junw-lab/halfLife/board.png

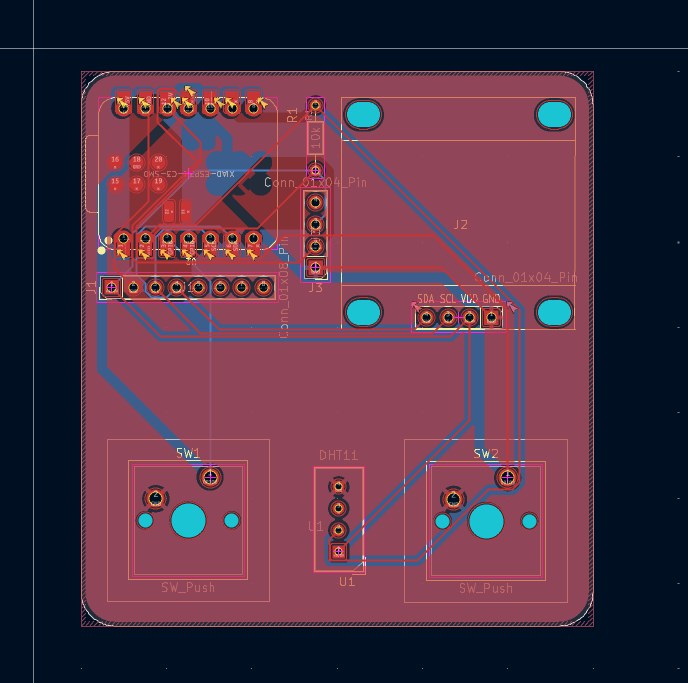
board.png
