junw-lab/halfLife/BOM.md

# Starbie – bill of materials

<!-- Generated by Half Life from project cmuvq4d1102cu01o92k2wubfl. Edits here are overwritten on the next sync. -->
<!-- Generated: 2026-10-11T10:39:23.504Z -->

> [!NOTE]
> This parts list is mirrored from [Half Life](https://halflife.hackclub.com). Editing it here will not change the platform's copy, and the next sync overwrites this file.

| Week | Tier | Parts funding |
| --- | --- | --- |
| Week 1 | Tier 1 | $30.00 |

| Part | What it's for | Qty | Unit | Total | Vendor |
| --- | --- | --- | --- | --- | --- |
| [PCB](https://jlcpcb.com/) | PCB | 1 | $1.50 | $1.50 | [JLCPCB](https://jlcpcb.com/) |
| [ESP 32 C3](https://www.aliexpress.com/item/1005008233414789.html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) | ESP | 1 | $5.62 | $5.62 | [Aliexpress](https://www.aliexpress.com/item/1005008233414789.html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) |
| [Brown Switch](https://www.aliexpress.com/item/1005006376024657.html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) | Switches | 10 | $0.32 | $3.20 | [Aliexpress](https://www.aliexpress.com/item/1005006376024657.html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) |
| [DHT 11](https://www.aliexpress.com/item/1005013226783513.html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) | temperature and humidity sensor | 1 | $2.10 | $2.10 | [Aliexpress](https://www.aliexpress.com/item/1005013226783513.html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) |
| [Keycaps](https://www.aliexpress.com/item/1005010720096151.html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) | Keycap | 10 | $0.27 | $2.70 | [Aliexpress](https://www.aliexpress.com/item/1005010720096151.html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) |
| [Oled module](https://www.aliexpress.com/item/32896971385.html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) | Screen | 1 | $1.60 | $1.60 | [Aliexpress](https://www.aliexpress.com/item/32896971385.html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) |
| [10k resistor](https://www.aliexpress.com/item/32952657927.html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) | resistors | 1 | $1.23 | $1.23 | [aliexpress](https://www.aliexpress.com/item/32952657927.html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) |
| [MPU 6050](https://www.aliexpress.com/item/1005008639359144.html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) | motion tracking | 1 | $2.33 | $2.33 | [Aliexpress](https://www.aliexpress.com/item/1005008639359144.html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) |
| **Parts subtotal** | — | — | — | **$20.28** | — |
| **Tax & shipping** | — | — | — | **$11.50** | — |
| **Total** | — | — | — | **$31.78** | — |

**$1.78 over the tier's funding.** Every tier gives a fixed amount for parts, so this needs cutting back or a higher tier.
