junw-lab/halfLife/KiCad Project.kicad_pcb

## KiCad design KiCad Project.kicad_pcb (2026-10-11)

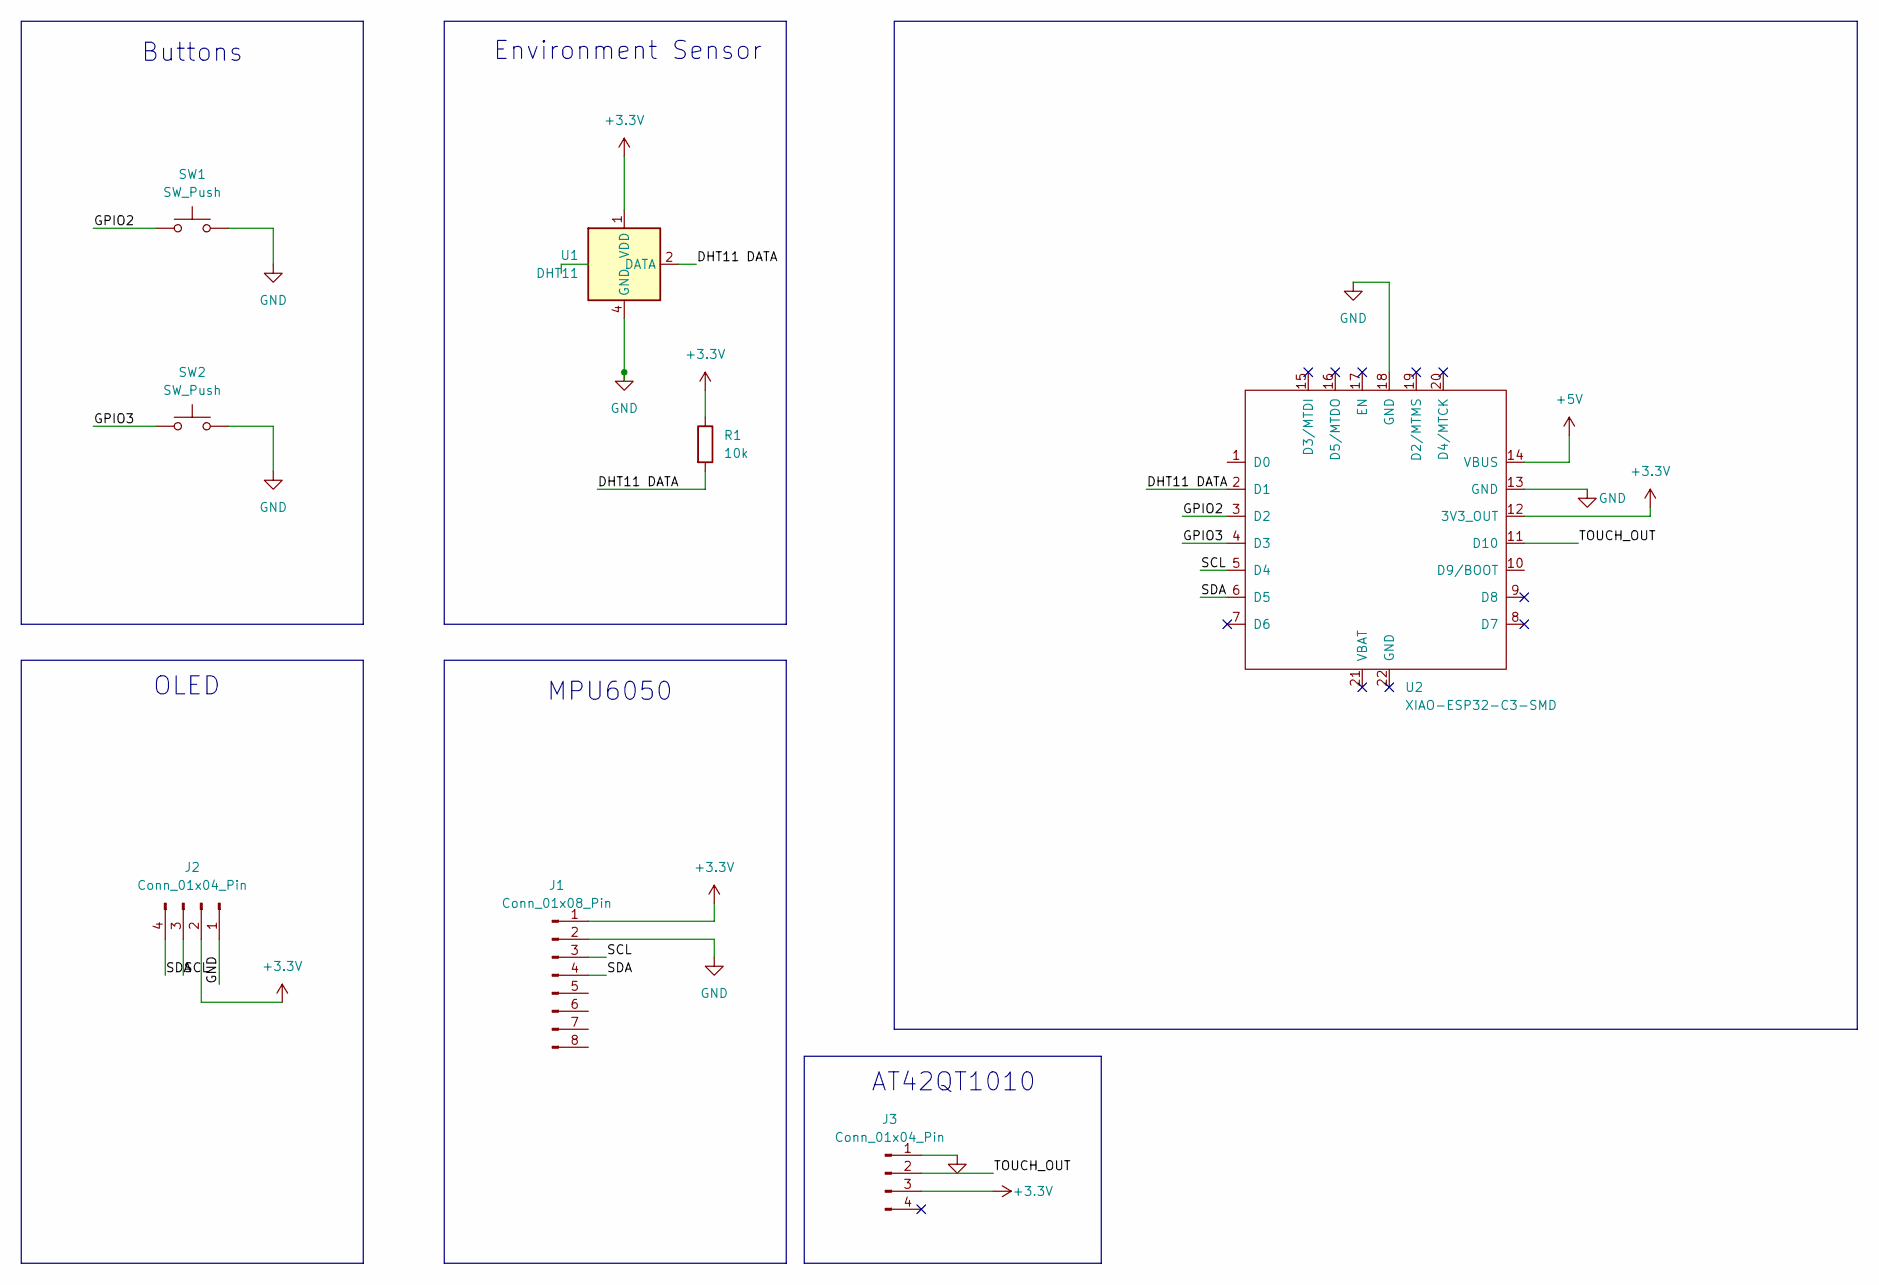
[picture p2: schematic KiCad Project.kicad_sch]

Parts:
J1: Conn_01x08_Pin; PinHeader_1x08_P2.54mm_Vertical
J2: Conn_01x04_Pin; Display_128x64_096_I2C
J3: Conn_01x04_Pin; PinHeader_1x04_P2.54mm_Vertical
R1: 10k; R_Axial_DIN0204_L3.6mm_D1.6mm_P7.62mm_Horizontal
SW1, SW2: SW_Push; SW_Cherry_MX_1.00u_PCB
U1: DHT11; Aosong_DHT11_5.5x12.0_P2.54mm
U2: XIAO-ESP32-C3-SMD; XIAO-ESP32-C3-DIP-SMD

Connections:
+3.3V: J1.1, J2.2, J3.3, R1.1, U1.1 (VDD), U2.12 (3V3_OUT)
+5V: U2.14 (VBUS)
/DHT11 DATA: R1.2, U1.2 (DATA), U2.2 (D1)
/GPIO2: SW1.1, U2.3 (D2)
/GPIO3: SW2.1, U2.4 (D3)
/SCL: J1.3, J2.3, U2.5 (D4)
/SDA: J1.4, J2.4, U2.6 (D5)
/TOUCH_OUT: J3.2, U2.11 (D10)
GND: J1.2, J2.1, J3.1, SW1.2, SW2.2, U1.4 (GND), U2.13 (GND), U2.18 (GND)

Notes on the sheet:
AT42QT1010
OLED
Buttons
Environment Sensor
MPU6050

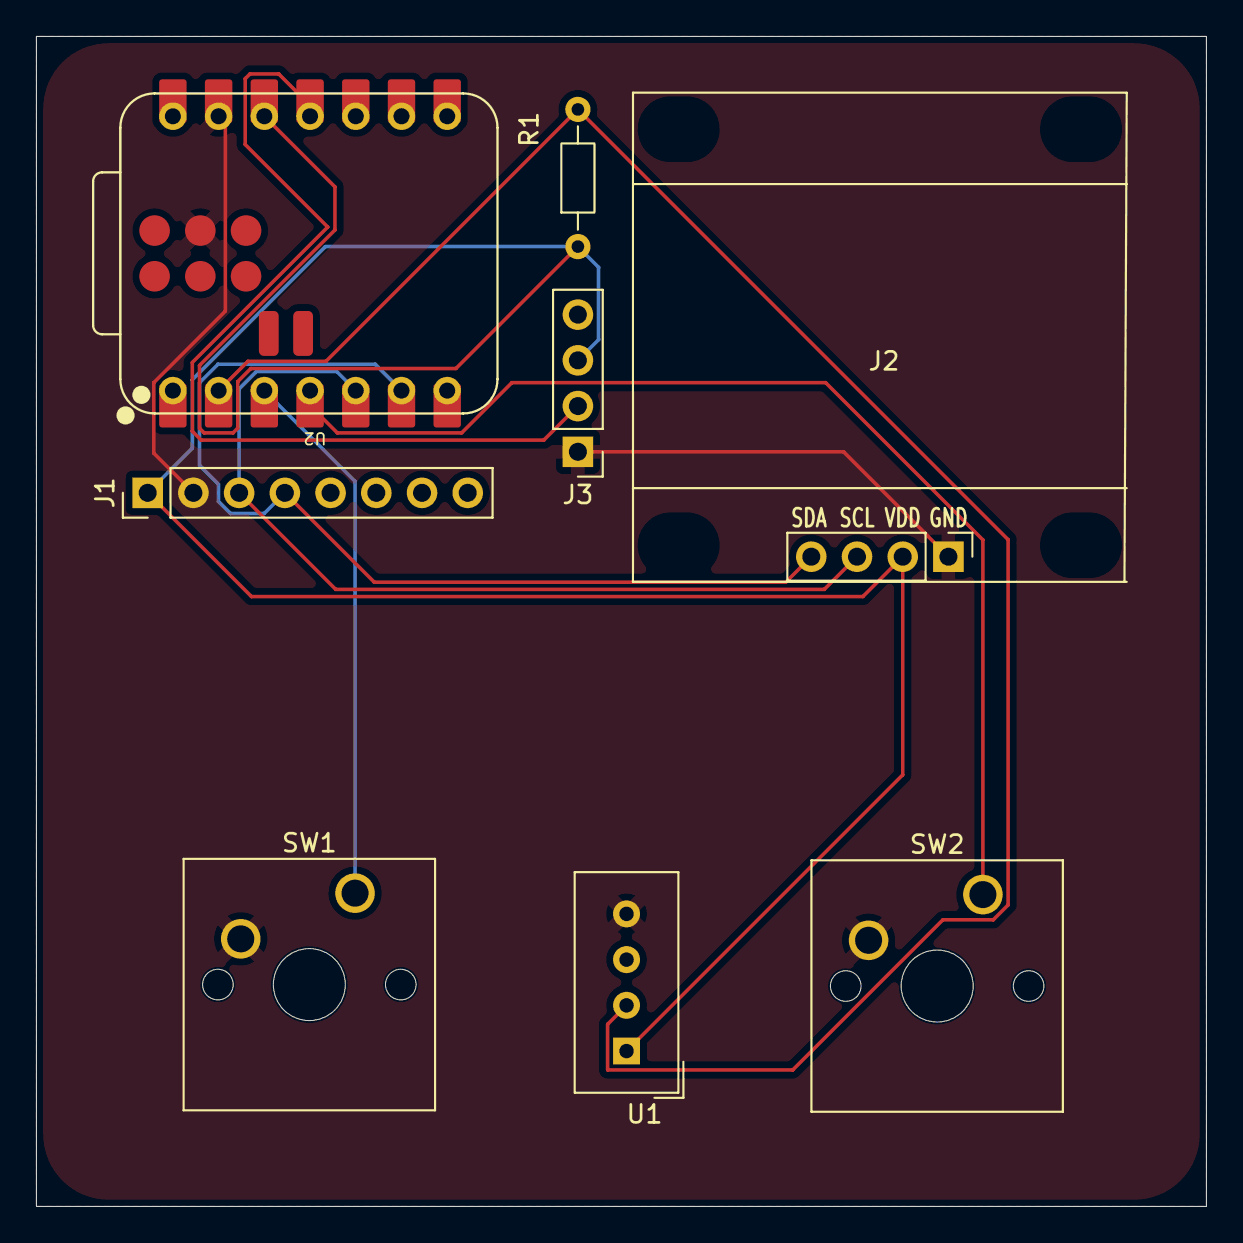
[picture p3: board KiCad Project.kicad_pcb from above]

Board: 2 copper layers, 65.0 x 65.0 mm, 8 parts (0 on the bottom side), 8 nets.
