junw-lab/halfLife/(commit log)

2026-10-10 Board image
2026-10-10 Add README with project details and schematics
    Added project description, components, and images.
2026-10-11 Added PCB and SCH files
